jackmaxg/FPGA_FOC_hardware/README.md

# FPGA_FOC_hardware
Hardware for the 6.111 FPGA_FOC project
