jackmaxg/FPGA_FOC_hardware/sim_n_calcs/resolver_amp/amplifier.asc

C1: cap; 10p
L1: ind; 1000µH
Q1: npn; ZTX1048A
Q2: npn; ZTX1048A
Q3: pnp; 2SAR533P
Q4: pnp; 2SAR533P
R1: res; 1k
R2: res; 2.4k
R3: res; 2.2k
R4: res; 3.3
R5: res; 3.3
R6: res; 2.2k
R7: res; 4.7
R8: res; 4.7
R9: res; 1k
R10: res; 416.6
U1: AD8664
V1: voltage; SINE(2.5 2.5 10000 0 0 0 10000)
V2: voltage; 5
V3: voltage; 12
V4: voltage; 6V
Named nets: 0, Vin, 5v, 12v, Vout
.tran 0 0.011 0.01
