jackmaxg/FPGA_FOC_hardware/FPGA_FOC_boards/motherboard.brd

## EAGLE design FPGA_FOC_boards/motherboard.brd (2020-01-12)

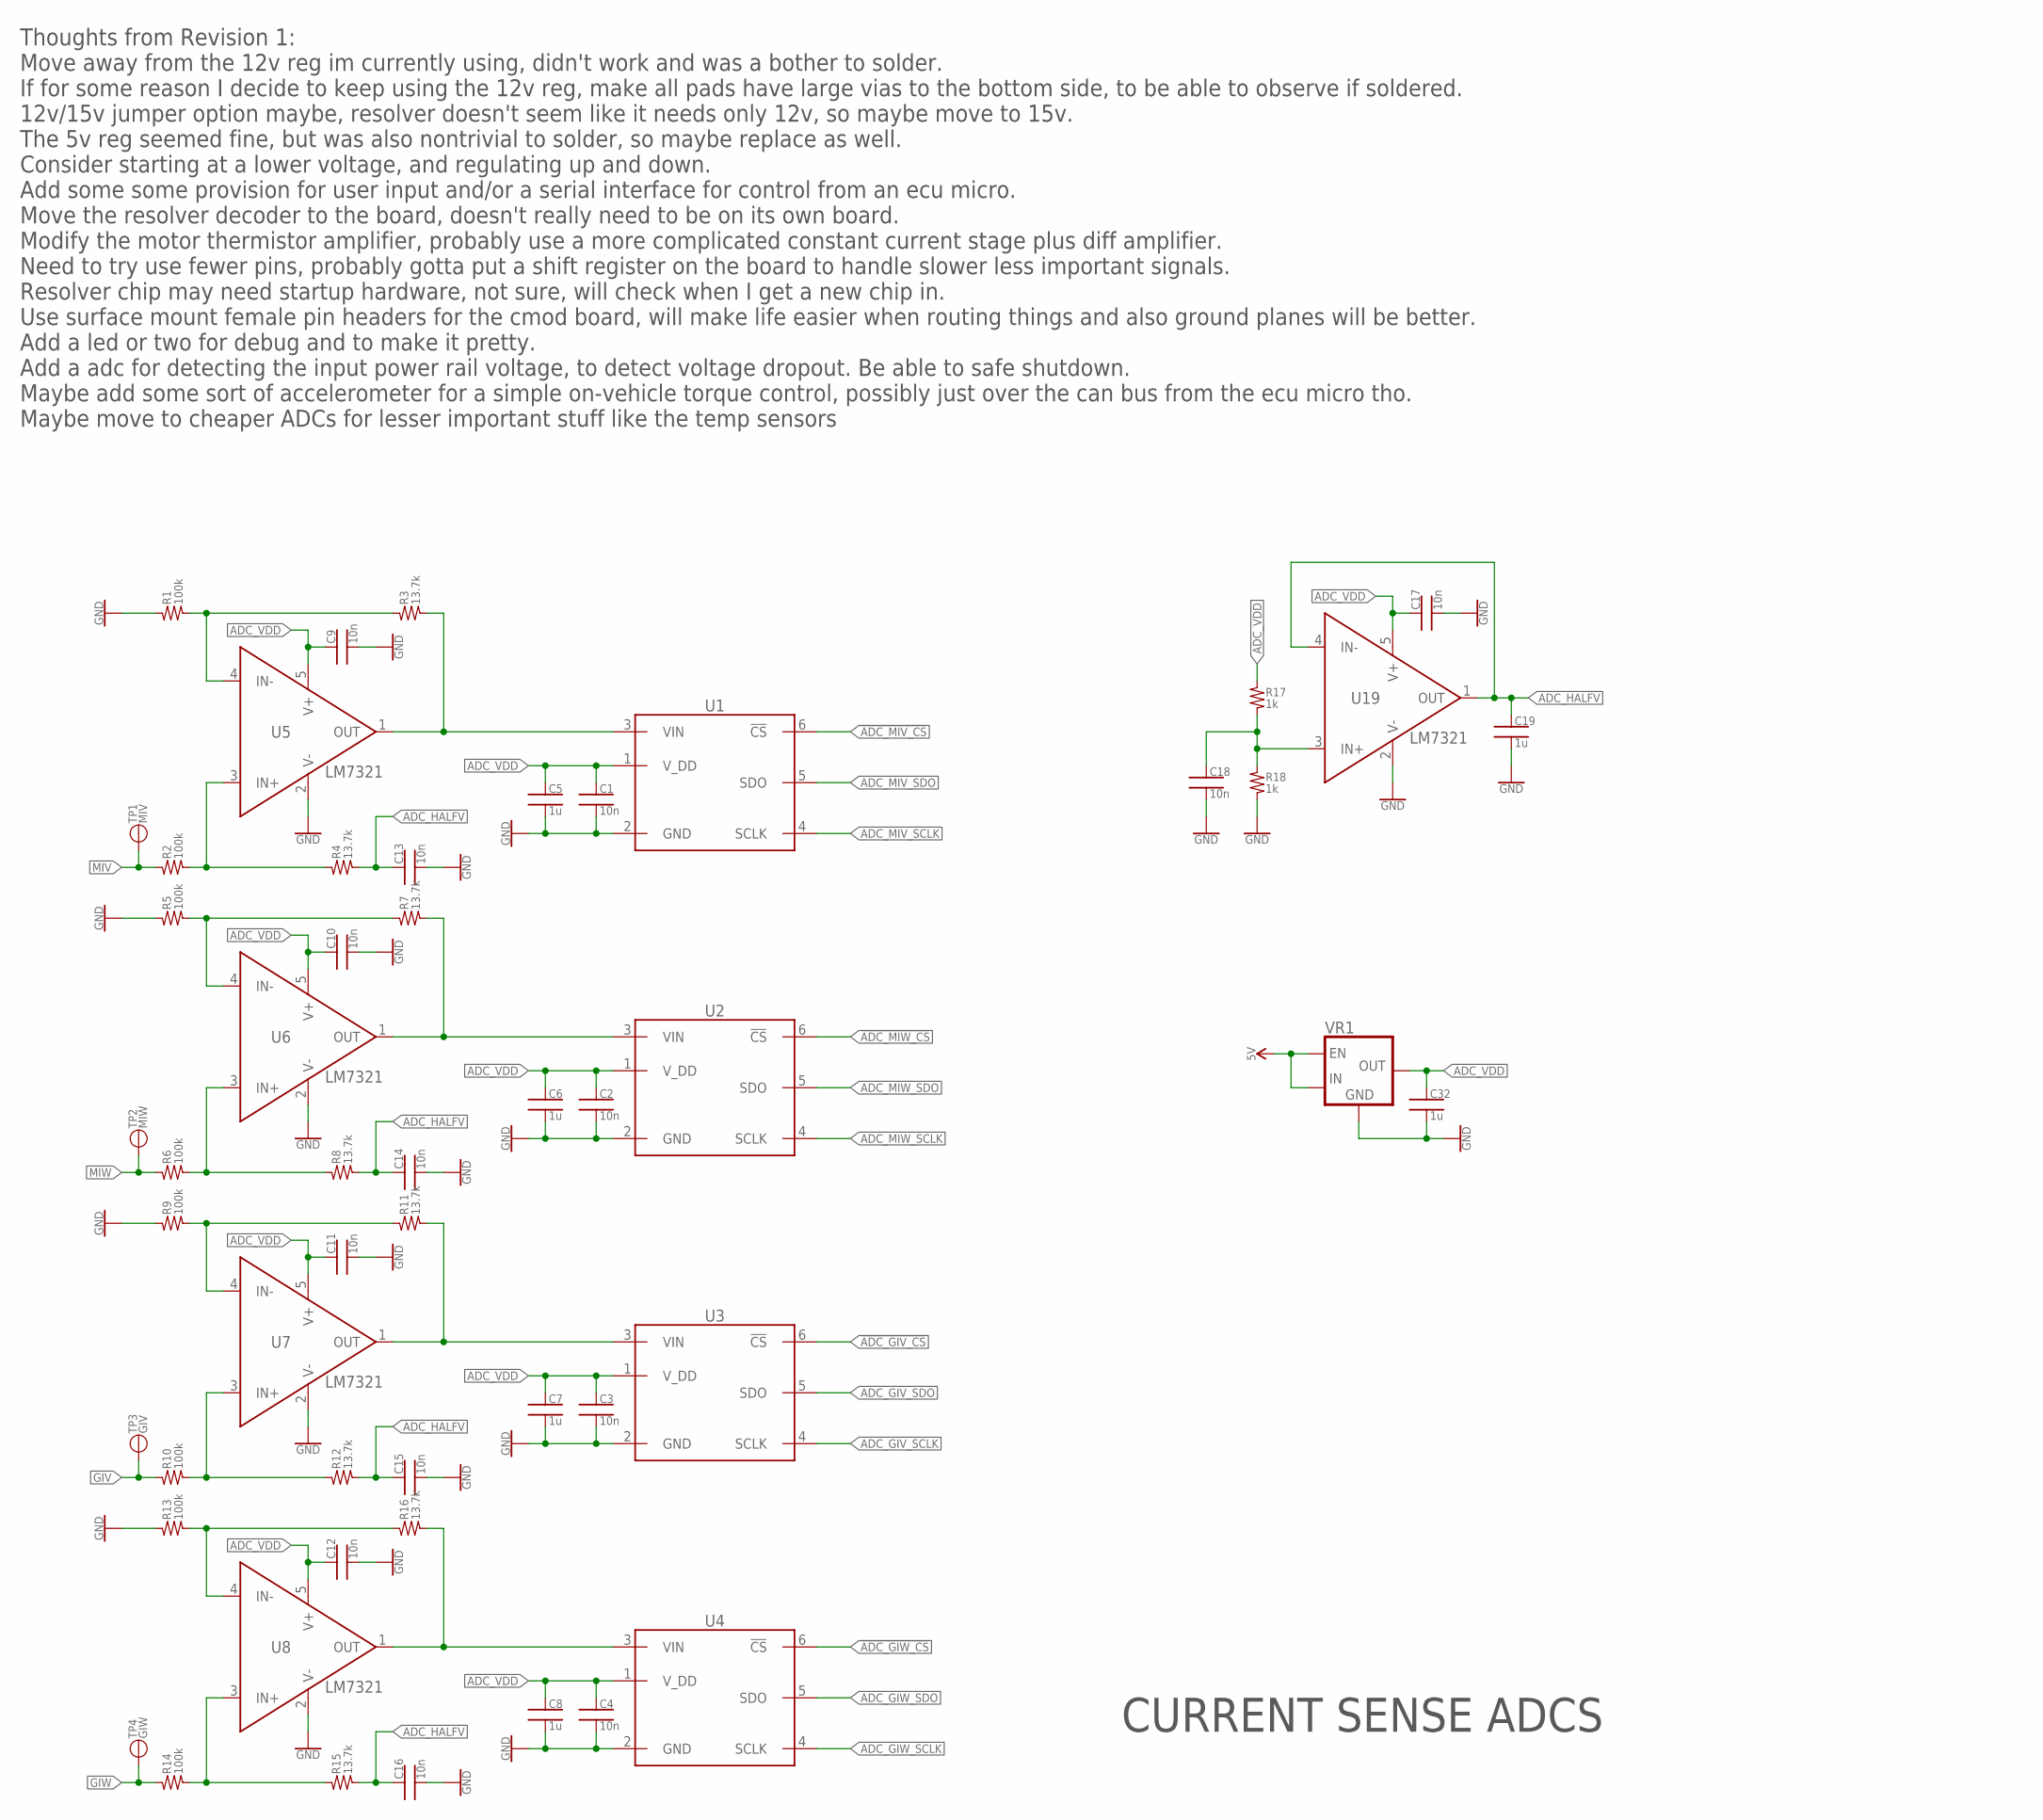
[picture p1: schematic motherboard.sch, sheet 1]

Parts:
C1, C2, C3, C4, C9, C10, C11, C12, C13, C14, C15, C16, C17, C18: 10n; 0402
C5, C6, C7, C8, C19, C32: 1u; 0402
R1, R2, R5, R6, R9, R10, R13, R14: 100k; 0402
R3, R4, R7, R8, R11, R12, R15, R16: 13.7k; 0402
R17, R18: 1k; 0402
TP1: MIV; 1X01_50MIL
TP2: MIW; 1X01_50MIL
TP3: GIV; 1X01_50MIL
TP4: GIW; 1X01_50MIL
U1, U2, U3, U4: ADS7883; SOT23-6
U5, U6, U7, U8, U19: LM7321; SOT23-5
VR1: TLV733P_SOT23; SOT23-5

Connections:
5V: VR1.1 (IN), VR1.3 (EN); also elsewhere on the board
!ADC_GIV_CS: U3.6 (!CS); also elsewhere on the board
!ADC_GIW_CS: U4.6 (!CS); also elsewhere on the board
!ADC_MIV_CS: U1.6 (!CS); also elsewhere on the board
!ADC_MIW_CS: U2.6 (!CS); also elsewhere on the board
ADC_GIV_SCLK: U3.4 (SCLK); also elsewhere on the board
ADC_GIV_SDO: U3.5 (SDO); also elsewhere on the board
ADC_GIW_SCLK: U4.4 (SCLK); also elsewhere on the board
ADC_GIW_SDO: U4.5 (SDO); also elsewhere on the board
ADC_HALFV: C13.1, C14.1, C15.1, C16.1, C19.1, R4.2, R8.2, R12.2, R15.2, U19.1 (OUT), U19.4 (IN-)
ADC_HALFV_REF: C18.1, R17.2, R18.1, U19.3 (IN+)
ADC_MIV_SCLK: U1.4 (SCLK); also elsewhere on the board
ADC_MIV_SDO: U1.5 (SDO); also elsewhere on the board
ADC_MIW_SCLK: U2.4 (SCLK); also elsewhere on the board
ADC_MIW_SDO: U2.5 (SDO); also elsewhere on the board
ADC_VDD: C1.1, C2.1, C3.1, C4.1, C5.1, C6.1, C7.1, C8.1, C9.1, C10.1, C11.1, C12.1, C17.1, C32.1, R17.1, U1.1 (V_DD), U2.1 (V_DD), U3.1 (V_DD), U4.1 (V_DD), U5.5 (V+), U6.5 (V+), U7.5 (V+), U8.5 (V+), U19.5 (V+), VR1.5 (OUT); also elsewhere on the board
GIV: R10.1, TP3.1; also elsewhere on the board
GIW: R14.1, TP4.1; also elsewhere on the board
GND: C1.2, C2.2, C3.2, C4.2, C5.2, C6.2, C7.2, C8.2, C9.2, C10.2, C11.2, C12.2, C13.2, C14.2, C15.2, C16.2, C17.2, C18.2, C19.2, C32.2, R1.1, R5.1, R9.1, R13.1, R18.2, U1.2 (GND), U2.2 (GND), U3.2 (GND), U4.2 (GND), U5.2 (V-), U6.2 (V-), U7.2 (V-), U8.2 (V-), U19.2 (V-), VR1.2 (GND), VR1.4 (GND); also elsewhere on the board
MIV: R2.1, TP1.1; also elsewhere on the board
MIW: R6.1, TP2.1; also elsewhere on the board
U5_IN+: R2.2, R4.1, U5.3 (IN+)
U5_IN-: R1.2, R3.1, U5.4 (IN-)
U5_OUT: R3.2, U1.3 (VIN), U5.1 (OUT)
U6_IN+: R6.2, R8.1, U6.3 (IN+)
U6_IN-: R5.2, R7.1, U6.4 (IN-)
U6_OUT: R7.2, U2.3 (VIN), U6.1 (OUT)
U7_IN+: R10.2, R12.1, U7.3 (IN+)
U7_IN-: R9.2, R11.1, U7.4 (IN-)
U7_OUT: R11.2, U3.3 (VIN), U7.1 (OUT)
U8_IN+: R14.2, R15.1, U8.3 (IN+)
U8_IN-: R13.2, R16.1, U8.4 (IN-)
U8_OUT: R16.2, U4.3 (VIN), U8.1 (OUT)

Notes on the sheet:
CURRENT SENSE ADCS
Thoughts from Revision 1: Move away from the 12v reg im currently using, didn't work and was a bother to solder. If for some reason I decide to keep using the 12v reg, make all pads have large vias to the bottom side, to be able to observe if soldered. 12v/15v jumper option maybe, resolver doesn't 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

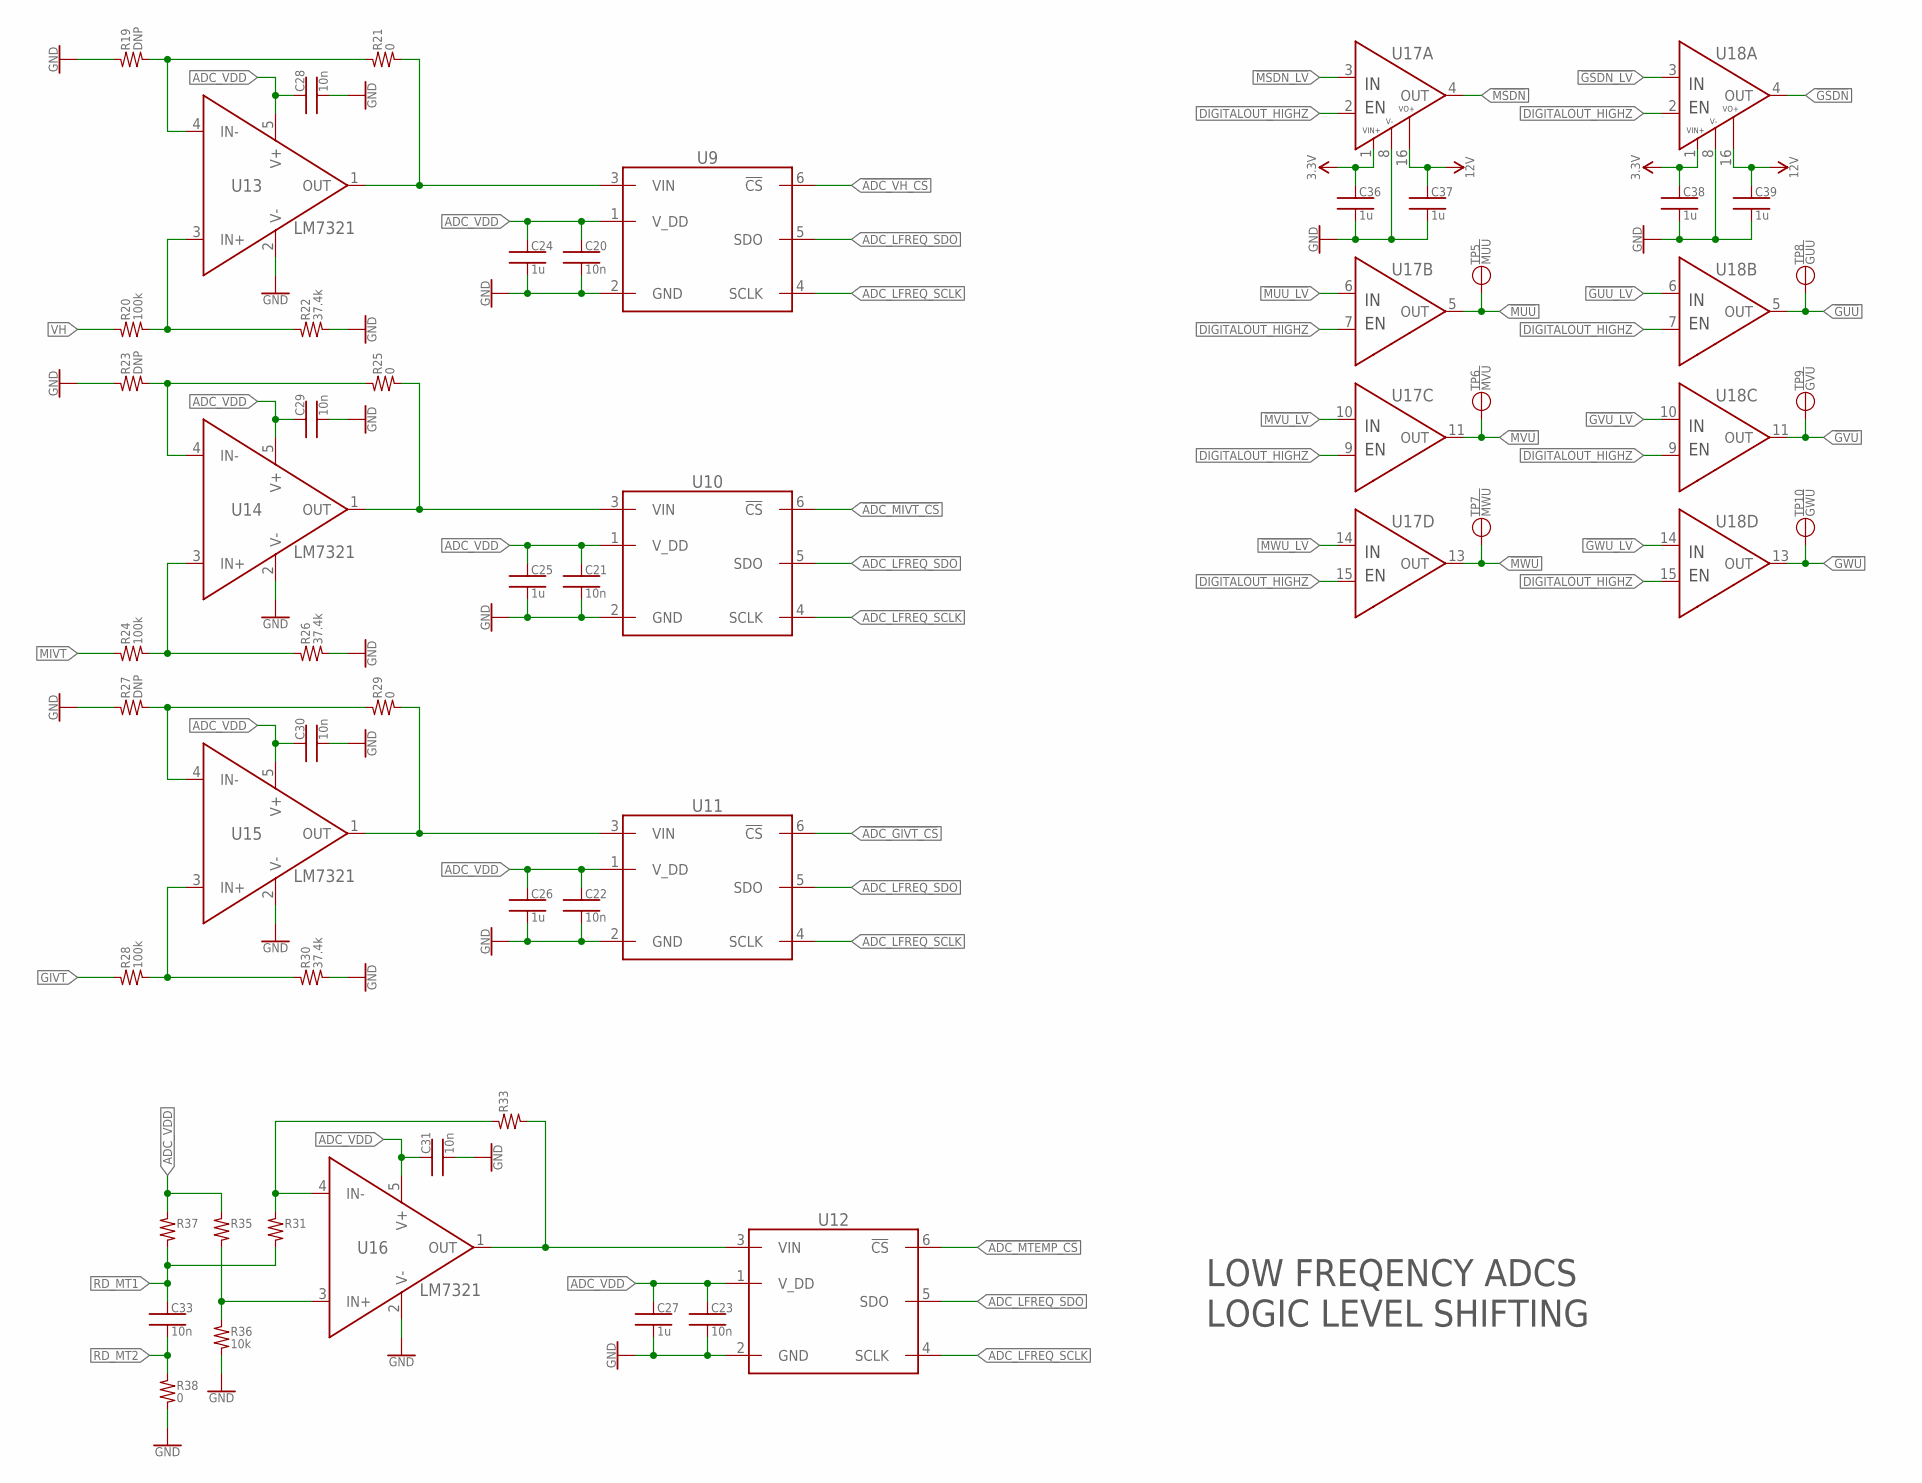
[picture p2: schematic motherboard.sch, sheet 2]

Parts:
C20, C21, C22, C23, C28, C29, C30, C31, C33: 10n; 0402
C24, C25, C26, C27, C36, C37, C38, C39: 1u; 0402
R19, R23, R27: DNP; 0402
R20, R24, R28: 100k; 0402
R21, R25, R29, R38: 0; 0402
R22, R26, R30: 37.4k; 0402
R31, R33, R35, R37: RES_SMD_0402; 0402
R36: 10k; 0402
TP5: !MUU; 1X01_50MIL
TP6: !MVU; 1X01_50MIL
TP7: !MWU; 1X01_50MIL
TP8: !GUU; 1X01_50MIL
TP9: !GVU; 1X01_50MIL
TP10: !GWU; 1X01_50MIL
U9, U10, U11, U12: ADS7883; SOT23-6
U13, U14, U15, U16: LM7321; SOT23-5
U17, U18: CD40109BPWR; TSSOP-16

Connections:
3.3V: C36.1, C38.1, U17.1 (VIN+), U18.1 (VIN+); also elsewhere on the board
12V: C37.1, C39.1, U17.16 (VOUT+), U18.16 (VOUT+); also elsewhere on the board
!ADC_GIVT_CS: U11.6 (!CS); also elsewhere on the board
!ADC_MIVT_CS: U10.6 (!CS); also elsewhere on the board
!ADC_MTEMP_CS: U12.6 (!CS); also elsewhere on the board
!ADC_VH_CS: U9.6 (!CS); also elsewhere on the board
!GSDN: U18.4 (OUT); also elsewhere on the board
!GSDN_LV: U18.3 (IN); also elsewhere on the board
!GUU: TP8.1, U18.5 (OUT); also elsewhere on the board
!GUU_LV: U18.6 (IN); also elsewhere on the board
!GVU: TP9.1, U18.11 (OUT); also elsewhere on the board
!GVU_LV: U18.10 (IN); also elsewhere on the board
!GWU: TP10.1, U18.13 (OUT); also elsewhere on the board
!GWU_LV: U18.14 (IN); also elsewhere on the board
!MSDN: U17.4 (OUT); also elsewhere on the board
!MSDN_LV: U17.3 (IN); also elsewhere on the board
!MUU: TP5.1, U17.5 (OUT); also elsewhere on the board
!MUU_LV: U17.6 (IN); also elsewhere on the board
!MVU: TP6.1, U17.11 (OUT); also elsewhere on the board
!MVU_LV: U17.10 (IN); also elsewhere on the board
!MWU: TP7.1, U17.13 (OUT); also elsewhere on the board
!MWU_LV: U17.14 (IN); also elsewhere on the board
ADC_LFREQ_SCLK: U9.4 (SCLK), U10.4 (SCLK), U11.4 (SCLK), U12.4 (SCLK); also elsewhere on the board
ADC_LFREQ_SDO: U9.5 (SDO), U10.5 (SDO), U11.5 (SDO), U12.5 (SDO); also elsewhere on the board
ADC_VDD: C20.1, C21.1, C22.1, C23.1, C24.1, C25.1, C26.1, C27.1, C28.1, C29.1, C30.1, C31.1, R35.1, R37.1, U9.1 (V_DD), U10.1 (V_DD), U11.1 (V_DD), U12.1 (V_DD), U13.5 (V+), U14.5 (V+), U15.5 (V+), U16.5 (V+); also elsewhere on the board
DIGITALOUT_HIGHZ: U17.2 (EN), U17.7 (EN), U17.9 (EN), U17.15 (EN), U18.2 (EN), U18.7 (EN), U18.9 (EN), U18.15 (EN)
GIVT: R28.1; also elsewhere on the board
GND: C20.2, C21.2, C22.2, C23.2, C24.2, C25.2, C26.2, C27.2, C28.2, C29.2, C30.2, C31.2, C36.2, C37.2, C38.2, C39.2, R19.1, R22.2, R23.1, R26.2, R27.1, R30.2, R36.2, R38.2, U9.2 (GND), U10.2 (GND), U11.2 (GND), U12.2 (GND), U13.2 (V-), U14.2 (V-), U15.2 (V-), U16.2 (V-), U17.8 (V-), U18.8 (V-); also elsewhere on the board
MIVT: R24.1; also elsewhere on the board
RD_MT1: C33.1, R31.2, R37.2
RD_MT2: C33.2, R38.1
U13_IN+: R20.2, R22.1, U13.3 (IN+)
U13_IN-: R19.2, R21.1, U13.4 (IN-)
U13_OUT: R21.2, U9.3 (VIN), U13.1 (OUT)
U14_IN+: R24.2, R26.1, U14.3 (IN+)
U14_IN-: R23.2, R25.1, U14.4 (IN-)
U14_OUT: R25.2, U10.3 (VIN), U14.1 (OUT)
U15_IN+: R28.2, R30.1, U15.3 (IN+)
U15_IN-: R27.2, R29.1, U15.4 (IN-)
U15_OUT: R29.2, U11.3 (VIN), U15.1 (OUT)
U16_IN+: R35.2, R36.1, U16.3 (IN+)
U16_IN-: R31.1, R33.1, U16.4 (IN-)
U16_OUT: R33.2, U12.3 (VIN), U16.1 (OUT)
VH: R20.1; also elsewhere on the board

Notes on the sheet:
LOW FREQENCY ADCS LOGIC LEVEL SHIFTING

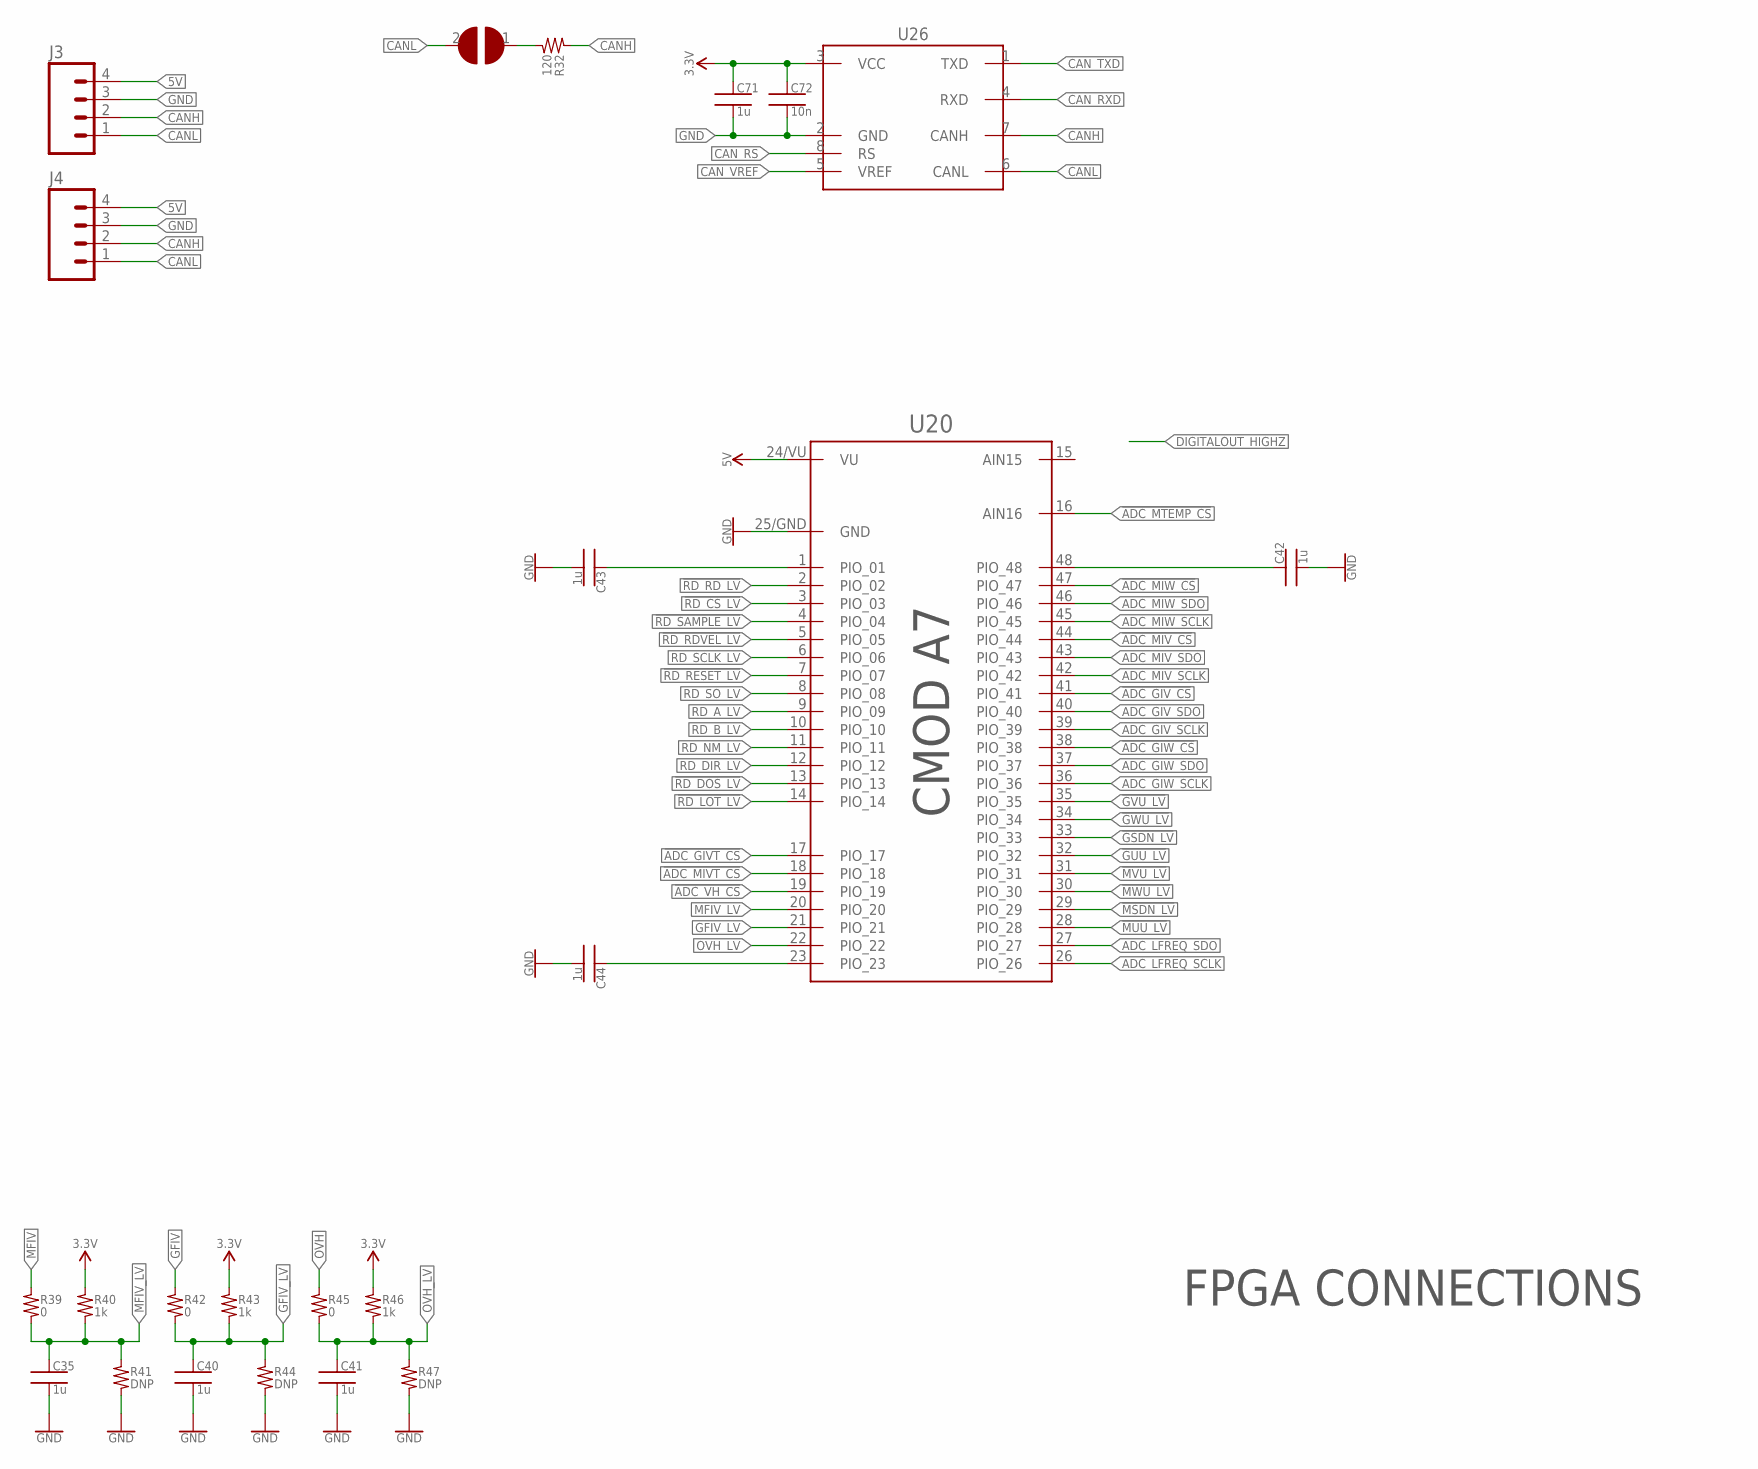
[picture p3: schematic motherboard.sch, sheet 3]

Parts:
C35, C40, C41, C42, C43, C44, C71: 1u; 0402
C72: 10n; 0402
J3, J4: SM04B-SRSS-TB
R32: 120; 0402
R39, R42, R45: 0; 0402
R40, R43, R46: 1k; 0402
R41, R44, R47: DNP; 0402
SJ1: SOLDERABLE_JUMPER_1POS_NP; SJ_2S-NO
U20: CMOD_A7; CMOD_A7_DIP
U26: SN65HVD23X; SOIC_8

Connections:
3.3V: C71.1, C72.1, R40.1, R43.1, R46.1, U26.3 (VCC); also elsewhere on the board
5V: J3.4, J4.4, U20.24/VU (VU); also elsewhere on the board
!ADC_GIVT_CS: U20.17 (PIO_17); also elsewhere on the board
!ADC_GIV_CS: U20.41 (PIO_41); also elsewhere on the board
!ADC_GIW_CS: U20.38 (PIO_38); also elsewhere on the board
!ADC_MIVT_CS: U20.18 (PIO_18); also elsewhere on the board
!ADC_MIV_CS: U20.44 (PIO_44); also elsewhere on the board
!ADC_MIW_CS: U20.47 (PIO_47); also elsewhere on the board
!ADC_MTEMP_CS: U20.16 (AIN16); also elsewhere on the board
!ADC_VH_CS: U20.19 (PIO_19); also elsewhere on the board
!GSDN_LV: U20.33 (PIO_33); also elsewhere on the board
!GUU_LV: U20.32 (PIO_32); also elsewhere on the board
!GVU_LV: U20.35 (PIO_35); also elsewhere on the board
!GWU_LV: U20.34 (PIO_34); also elsewhere on the board
!MSDN_LV: U20.29 (PIO_29); also elsewhere on the board
!MUU_LV: U20.28 (PIO_28); also elsewhere on the board
!MVU_LV: U20.31 (PIO_31); also elsewhere on the board
!MWU_LV: U20.30 (PIO_30); also elsewhere on the board
!RD_CS_LV: U20.3 (PIO_03); also elsewhere on the board
!RD_DOS_LV: U20.13 (PIO_13); also elsewhere on the board
!RD_LOT_LV: U20.14 (PIO_14); also elsewhere on the board
!RD_RDVEL_LV: U20.5 (PIO_05); also elsewhere on the board
!RD_RD_LV: U20.2 (PIO_02); also elsewhere on the board
!RD_RESET_LV: U20.7 (PIO_07); also elsewhere on the board
!RD_SAMPLE_LV: U20.4 (PIO_04); also elsewhere on the board
ADC_GIV_SCLK: U20.39 (PIO_39); also elsewhere on the board
ADC_GIV_SDO: U20.40 (PIO_40); also elsewhere on the board
ADC_GIW_SCLK: U20.36 (PIO_36); also elsewhere on the board
ADC_GIW_SDO: U20.37 (PIO_37); also elsewhere on the board
ADC_LFREQ_SCLK: U20.26 (PIO_26); also elsewhere on the board
ADC_LFREQ_SDO: U20.27 (PIO_27); also elsewhere on the board
ADC_MIV_SCLK: U20.42 (PIO_42); also elsewhere on the board
ADC_MIV_SDO: U20.43 (PIO_43); also elsewhere on the board
ADC_MIW_SCLK: U20.45 (PIO_45); also elsewhere on the board
ADC_MIW_SDO: U20.46 (PIO_46); also elsewhere on the board
CANH: J3.2, J4.2, R32.1, U26.7 (CANH)
CANL: J3.1, J4.1, SJ1.2, U26.6 (CANL)
CAN_RS: U26.8 (RS)
CAN_RXD: U26.4 (RXD)
CAN_TXD: U26.1 (TXD)
CAN_VREF: U26.5 (VREF)
GFIV: R42.1; also elsewhere on the board
GFIV_LV: C40.1, R42.2, R43.2, R44.1, U20.21 (PIO_21)
GND: C35.2, C40.2, C41.2, C42.2, C43.2, C44.2, C71.2, C72.2, J3.3, J4.3, R41.2, R44.2, R47.2, U20.25/GND (GND), U26.2 (GND); also elsewhere on the board
MFIV: R39.1; also elsewhere on the board
MFIV_LV: C35.1, R39.2, R40.2, R41.1, U20.20 (PIO_20)
unnamed: R32.2, SJ1.1
OVH: R45.1; also elsewhere on the board
OVH_LV: C41.1, R45.2, R46.2, R47.1, U20.22 (PIO_22)
PIO_01: C43.1, U20.1 (PIO_01)
PIO_23: C44.1, U20.23 (PIO_23)
PIO_48: C42.1, U20.48 (PIO_48)
RD_A_LV: U20.9 (PIO_09); also elsewhere on the board
RD_B_LV: U20.10 (PIO_10); also elsewhere on the board
RD_DIR_LV: U20.12 (PIO_12); also elsewhere on the board
RD_NM_LV: U20.11 (PIO_11); also elsewhere on the board
RD_SCLK_LV: U20.6 (PIO_06); also elsewhere on the board
RD_SO_LV: U20.8 (PIO_08); also elsewhere on the board

Notes on the sheet:
FPGA CONNECTIONS

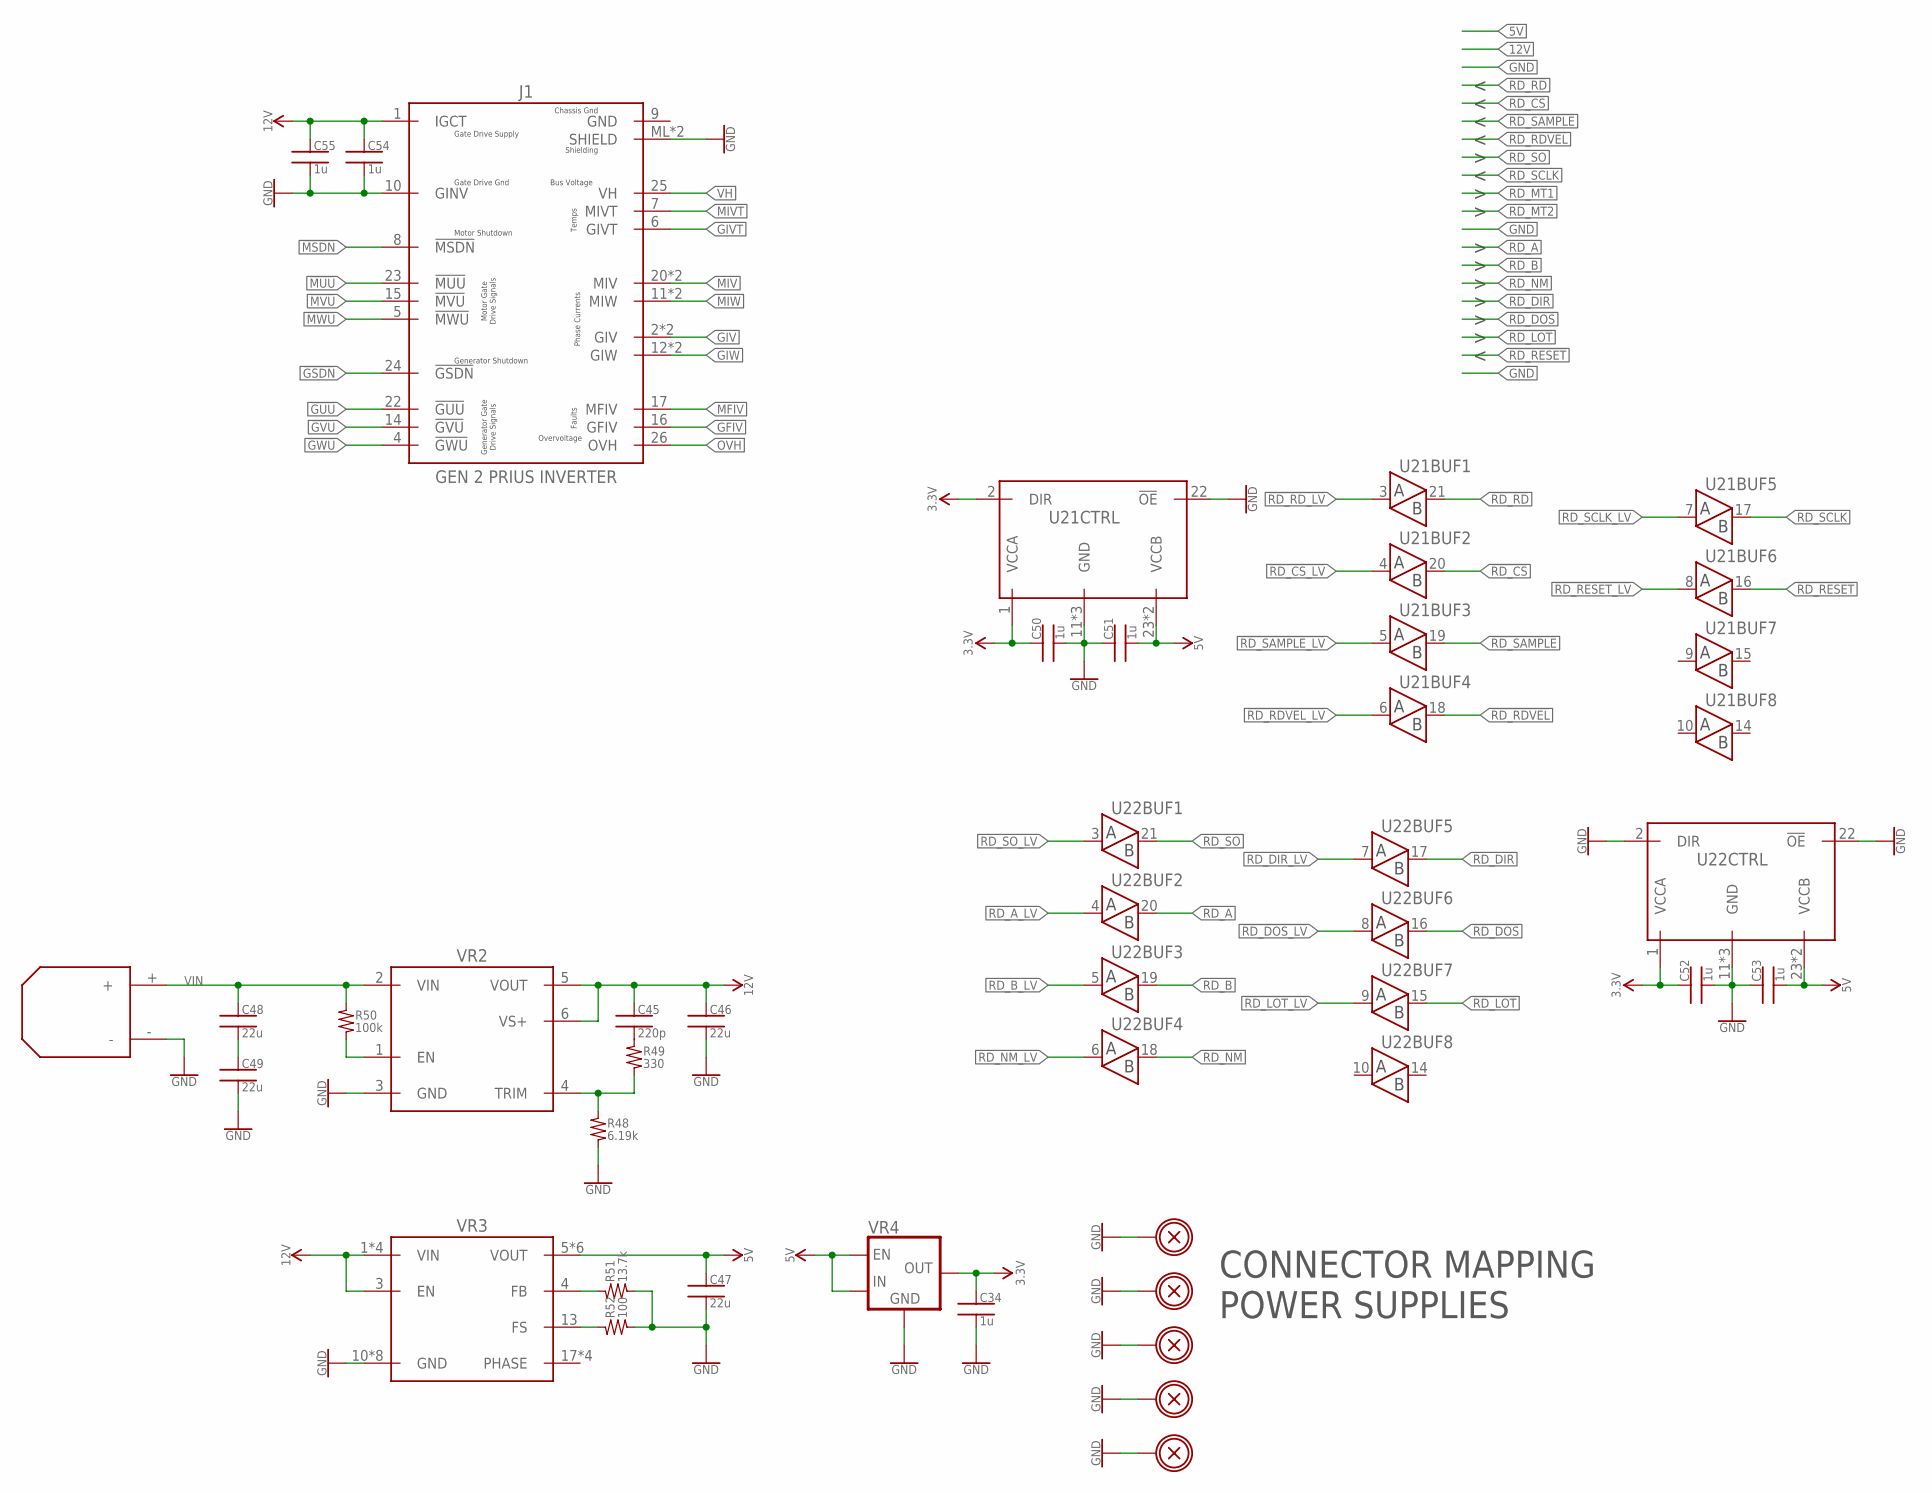
[picture p4: schematic motherboard.sch, sheet 4]

Parts:
C34, C50, C51, C52, C53, C54, C55: 1u; 0402
C45: 220p; 0402
C46, C47, C48, C49: 22u; 1210
H1, H2, H3, H4, H5: BOLTHOLE_M3; M3_HOLE
J1: PRIUS_INV_DB26; L17HTHA
R48: 6.19k; 0402
R49: 330; 0402
R50: 100k; 0402
R51: 13.7k; 0402
R52: 100; 0402
U21, U22: 74LVC8T245; TSSOP-24
U$1: XT30; XT30_HORIZONTAL
VR2: PROLYNX
VR3: MUN24AD03-SM; UPOL_PWR_MODULE
VR4: TLV733P_SOT23; SOT23-5

Connections:
3.3V: C34.1, C50.1, C52.1, U21.1 (VCCA), U21.2 (DIR), U22.1 (VCCA), VR4.5 (OUT); also elsewhere on the board
5V: C47.1, C51.2, C53.2, U21.23 (VCCB), U21.24 (VCCB), U22.23 (VCCB), U22.24 (VCCB), VR3.5 (VOUT), VR3.6 (VOUT), VR3.7 (VOUT), VR3.8 (VOUT), VR3.9 (VOUT), VR3.24 (VOUT), VR4.1 (IN), VR4.3 (EN); also elsewhere on the board
12V: C45.1, C46.1, C54.1, C55.1, J1.1 (IGCT), VR2.5 (VOUT), VR2.6 (VS+), VR3.1 (VIN), VR3.2 (VIN), VR3.3 (EN), VR3.20 (VIN), VR3.21 (VIN); also elsewhere on the board
!GSDN: J1.24 (!GSDN); also elsewhere on the board
!GUU: J1.22 (!GUU); also elsewhere on the board
!GVU: J1.14 (!GVU); also elsewhere on the board
!GWU: J1.4 (!GWU); also elsewhere on the board
!MSDN: J1.8 (!MSDN); also elsewhere on the board
!MUU: J1.23 (!MUU); also elsewhere on the board
!MVU: J1.15 (!MVU); also elsewhere on the board
!MWU: J1.5 (!MWU); also elsewhere on the board
!RD_CS: U21.20 (B); also elsewhere on the board
!RD_CS_LV: U21.4 (A); also elsewhere on the board
!RD_DOS: U22.16 (B); also elsewhere on the board
!RD_DOS_LV: U22.8 (A); also elsewhere on the board
!RD_LOT: U22.15 (B); also elsewhere on the board
!RD_LOT_LV: U22.9 (A); also elsewhere on the board
!RD_RD: U21.21 (B); also elsewhere on the board
!RD_RDVEL: U21.18 (B); also elsewhere on the board
!RD_RDVEL_LV: U21.6 (A); also elsewhere on the board
!RD_RD_LV: U21.3 (A); also elsewhere on the board
!RD_RESET: U21.16 (B); also elsewhere on the board
!RD_RESET_LV: U21.8 (A); also elsewhere on the board
!RD_SAMPLE: U21.19 (B); also elsewhere on the board
!RD_SAMPLE_LV: U21.5 (A); also elsewhere on the board
GFIV: J1.16 (GFIV); also elsewhere on the board
GIV: J1.2 (GIV), J1.3 (GIV); also elsewhere on the board
GIVT: J1.6 (GIVT); also elsewhere on the board
GIW: J1.12 (GIW), J1.13 (GIW); also elsewhere on the board
GND: C34.2, C46.2, C47.2, C49.2, C50.2, C51.1, C52.2, C53.1, C54.2, C55.2, H1.P, H2.P, H3.P, H4.P, H5.P, J1.10 (GINV), J1.ML (SHIELD), J1.MR (SHIELD), R48.2, R51.2, R52.2, U21.11 (GND), U21.12 (GND), U21.13 (GND), U21.22 (!OE), U22.2 (DIR), U22.11 (GND), U22.12 (GND), U22.13 (GND), U22.22 (!OE), U$1.-, VR2.3 (GND), VR3.10 (GND), VR3.11 (GND), VR3.12 (GND), VR3.14 (GND), VR3.15 (GND), VR3.16 (GND), VR3.23 (GND), VR3.25 (GND), VR4.2 (GND), VR4.4 (GND); also elsewhere on the board
MFIV: J1.17 (MFIV); also elsewhere on the board
MIV: J1.20 (MIV), J1.21 (MIV); also elsewhere on the board
MIVT: J1.7 (MIVT); also elsewhere on the board
MIW: J1.11 (MIW), J1.19 (MIW); also elsewhere on the board
unnamed: C45.2, R49.1
OVH: J1.26 (OVH); also elsewhere on the board
RD_A: U22.20 (B); also elsewhere on the board
RD_A_LV: U22.4 (A); also elsewhere on the board
RD_B: U22.19 (B); also elsewhere on the board
RD_B_LV: U22.5 (A); also elsewhere on the board
RD_DIR: U22.17 (B); also elsewhere on the board
RD_DIR_LV: U22.7 (A); also elsewhere on the board
RD_NM: U22.18 (B); also elsewhere on the board
RD_NM_LV: U22.6 (A); also elsewhere on the board
RD_SCLK: U21.17 (B); also elsewhere on the board
RD_SCLK_LV: U21.7 (A); also elsewhere on the board
RD_SO: U22.21 (B); also elsewhere on the board
RD_SO_LV: U22.3 (A); also elsewhere on the board
VH: J1.25 (VH); also elsewhere on the board
VIN: C48.1, R50.1, U$1.+, VR2.2 (VIN)
VIN_BYP_MID: C48.2, C49.1
VR2_EN: R50.2, VR2.1 (EN)
VR2_TRIM: R48.1, R49.2, VR2.4 (TRIM)
VR3_FB: R51.1, VR3.4 (FB)
VR3_FS: R52.1, VR3.13 (FS)

Notes on the sheet:
CONNECTOR MAPPING POWER SUPPLIES
