jackmaxg/FPGA_FOC_hardware/FPGA_FOC_boards/motherboard.brd

## EAGLE design FPGA_FOC_boards/motherboard.brd (continued)

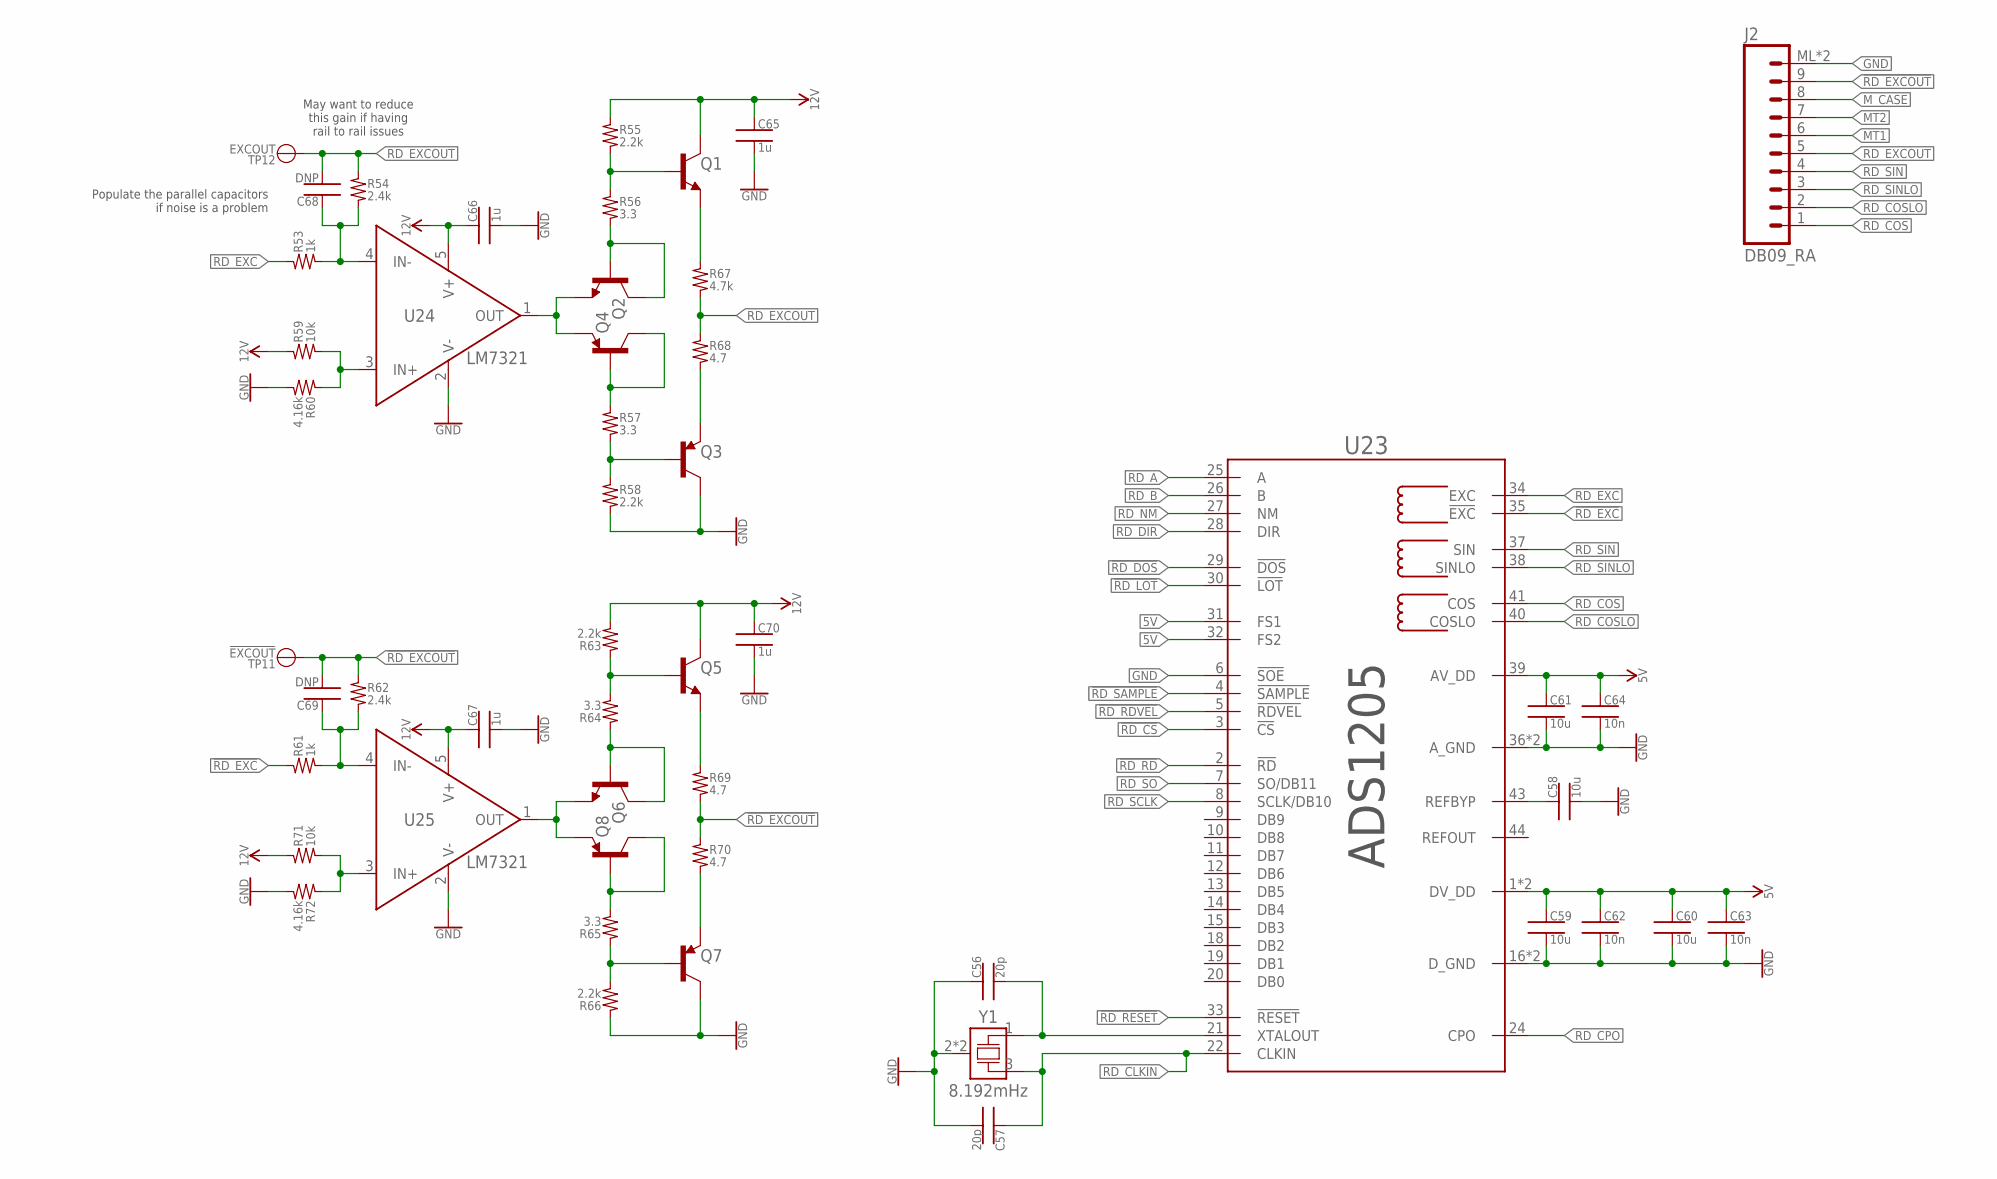
[picture p5: schematic motherboard.sch, sheet 5]

Parts:
C56, C57: 20p; 0402
C58, C59, C60, C61: 10u; 0603
C62, C63, C64: 10n; 0402
C65, C66, C67, C70: 1u; 0402
C68, C69: DNP; 0402
J2: DB09_RA; AE10921
Q1, Q2, Q5, Q6: BJT_NPN; SOT23-3
Q3, Q4, Q7, Q8: BJT_PNP; SOT23-3
R53, R61: 1k; 0402
R54, R62: 2.4k; 0402
R55, R58, R63, R66: 2.2k; 0402
R56, R57, R64, R65: 3.3; 0402
R59, R71: 10k; 0402
R60, R72: 4.16k; 0402
R67: 4.7k; 0805
R68, R69, R70: 4.7; 0805
TP11: !EXCOUT; 1X01_50MIL
TP12: EXCOUT; 1X01_50MIL
U23: ADS1205; LQFP44
U24, U25: LM7321; SOT23-5
Y1: 8.192mHz; 5X3.2MM_SMD_XTAL

Connections:
5V: C59.1, C60.1, C61.1, C62.1, C63.1, C64.1, U23.1 (DV_DD), U23.17 (DV_DD), U23.31 (FS1), U23.32 (FS2), U23.39 (AV_DD); also elsewhere on the board
12V: C65.1, C66.1, C67.1, C70.1, Q1.3 (C), Q5.3 (C), R55.1, R59.1, R63.2, R71.1, U24.5 (V+), U25.5 (V+); also elsewhere on the board
!RD_CS: U23.3 (!CS); also elsewhere on the board
!RD_DOS: U23.29 (!DOS); also elsewhere on the board
!RD_EXC: R61.1, U23.35 (!EXC)
!RD_EXCOUT: C69.2, J2.9, R62.1, R69.2, R70.1, TP11.1
!RD_LOT: U23.30 (!LOT); also elsewhere on the board
!RD_RD: U23.2 (!RD); also elsewhere on the board
!RD_RDVEL: U23.5 (!RDVEL); also elsewhere on the board
!RD_RESET: U23.33 (!RESET); also elsewhere on the board
!RD_SAMPLE: U23.4 (!SAMPLE); also elsewhere on the board
GND: C56.1, C57.2, C58.2, C59.2, C60.2, C61.2, C62.2, C63.2, C64.2, C65.2, C66.2, C67.2, C70.2, J2.ML (10), J2.MR (10), Q3.3 (C), Q7.3 (C), R58.2, R60.2, R66.1, R72.2, U23.6 (!SOE), U23.16 (D_GND), U23.23 (D_GND), U23.36 (A_GND), U23.42 (A_GND), U24.2 (V-), U25.2 (V-), Y1.2 (CASE), Y1.4 (CASE); also elsewhere on the board
MT1: J2.6
MT2: J2.7
M_CASE: J2.8
Q1_BASE: Q1.1 (B), R55.2, R56.1
Q1_EMITTER: Q1.2 (E), R67.1
Q2_BC: Q2.1 (B), Q2.3 (C), R56.2
Q3_BASE: Q3.1 (B), R57.2, R58.1
Q3_EMITTER: Q3.2 (E), R68.2
Q4_BC: Q4.1 (B), Q4.3 (C), R57.1
Q5_BASE: Q5.1 (B), R63.1, R64.2
Q5_EMITTER: Q5.2 (E), R69.1
Q6_BC: Q6.1 (B), Q6.3 (C), R64.1
Q7_BASE: Q7.1 (B), R65.1, R66.2
Q7_EMITTER: Q7.2 (E), R70.2
Q8_BC: Q8.1 (B), Q8.3 (C), R65.2
RD_A: U23.25 (A); also elsewhere on the board
RD_B: U23.26 (B); also elsewhere on the board
RD_CLKIN: C57.1, U23.22 (CLKIN), Y1.3 (X2)
RD_COS: J2.1, U23.41 (COS)
RD_COSLO: J2.2, U23.40 (COSLO)
RD_CPO: U23.24 (CPO)
RD_DIR: U23.28 (DIR); also elsewhere on the board
RD_EXC: R53.1, U23.34 (EXC)
RD_EXCOUT: C68.2, J2.5, R54.1, R67.2, R68.1, TP12.1
RD_NM: U23.27 (NM); also elsewhere on the board
RD_REFBYP: C58.1, U23.43 (REFBYP)
RD_SCLK: U23.8 (SCLK/DB10); also elsewhere on the board
RD_SIN: J2.4, U23.37 (SIN)
RD_SINLO: J2.3, U23.38 (SINLO)
RD_SO: U23.7 (SO/DB11); also elsewhere on the board
RD_XTALOUT: C56.2, U23.21 (XTALOUT), Y1.1 (X1)
U24_IN+: R59.2, R60.1, U24.3 (IN+)
U24_IN-: C68.1, R53.2, R54.2, U24.4 (IN-)
U24_OUT: Q2.2 (E), Q4.2 (E), U24.1 (OUT)
U25_IN+: R71.2, R72.1, U25.3 (IN+)
U25_IN-: C69.1, R61.2, R62.2, U25.4 (IN-)
U25_OUT: Q6.2 (E), Q8.2 (E), U25.1 (OUT)

Notes on the sheet:
Populate the parallel capacitors if noise is a problem
May want to reduce this gain if having rail to rail issues

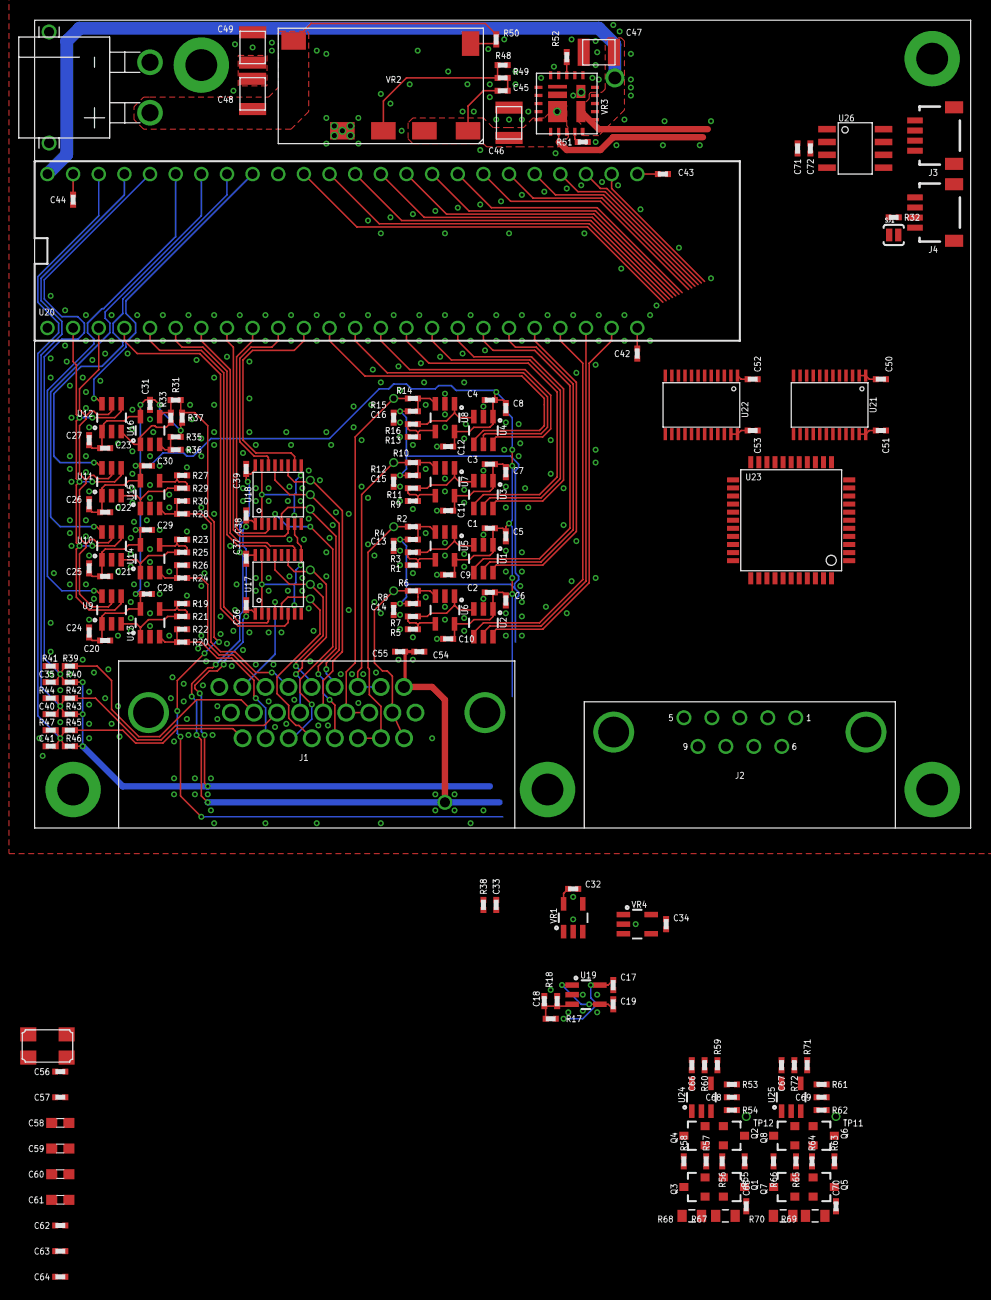
[picture p6: board motherboard.brd from above]

Board: 2 copper layers, 92.7 x 80.0 mm, 205 parts (0 on the bottom side), 149 nets.
