jackmaxg/FPGA_FOC_hardware/FPGA_FOC_boards/ResolverBoard.brd

## EAGLE design FPGA_FOC_boards/ResolverBoard.brd (2019-11-25)

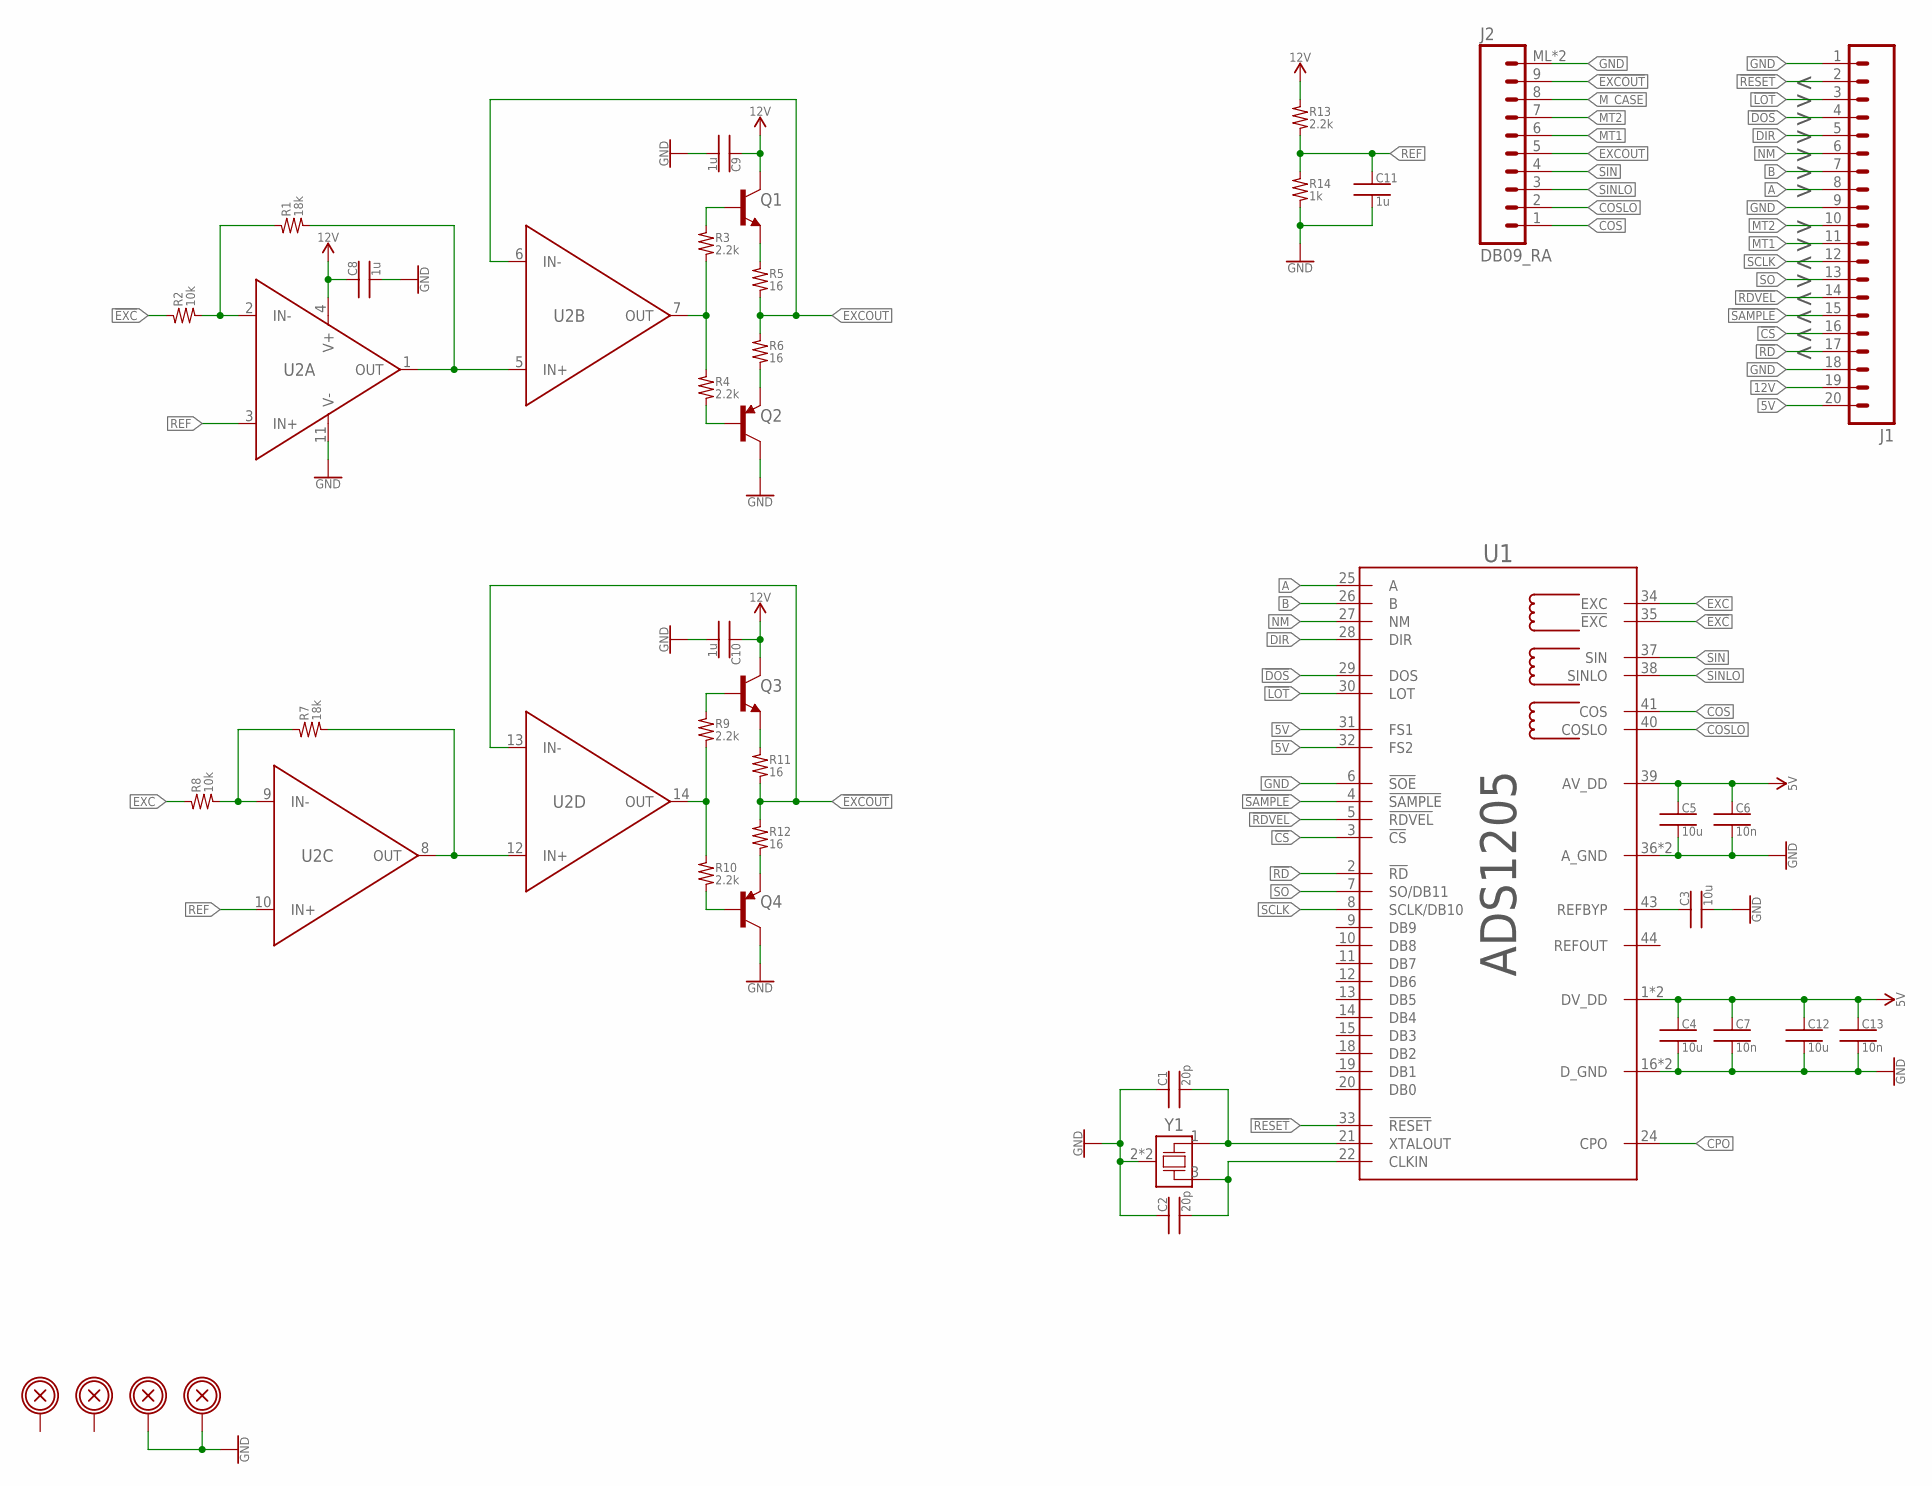
[picture p7: schematic ResolverBoard.sch]

Parts:
C1, C2: 20p; 0402
C3, C4, C5, C12: 10u; 0603
C6, C7, C13: 10n; 0402
C8, C9, C10, C11: 1u; 0402
H1, H2, H3, H4: BOLTHOLE_M3; M3_HOLE
J1: M20; 1X20
J2: DB09_RA; AE10921
Q1, Q3: BJT_NPN; SOT23-3
Q2, Q4: BJT_PNP; SOT23-3
R1, R7: 18k; 0402
R2, R8: 10k; 0402
R3, R4, R9, R10, R13: 2.2k; 0402
R5, R6, R11, R12: 16; 0805
R14: 1k; 0402
U1: ADS1205; LQFP44
U2: OPA4171D; SOIC_14
Y1: LFXTAL061486; 5X3.2MM_SMD_XTAL

Connections:
5V: C4.1, C5.1, C6.1, C7.1, C12.1, C13.1, J1.20, U1.1 (DV_DD), U1.17 (DV_DD), U1.31 (FS1), U1.32 (FS2), U1.39 (AV_DD)
12V: C8.1, C9.1, C10.1, J1.19, Q1.3 (C), Q3.3 (C), R13.1, U2.4 (V+)
!CS: J1.16, U1.3 (!CS)
!DOS: J1.4, U1.29 (DOS)
!EXC: R2.1, U1.35 (!EXC)
!EXCOUT: J2.9, R11.2, R12.1, U2.13 (IN-)
!LOT: J1.3, U1.30 (LOT)
!RD: J1.17, U1.2 (!RD)
!RDVEL: J1.14, U1.5 (!RDVEL)
!RESET: J1.2, U1.33 (!RESET)
!SAMPLE: J1.15, U1.4 (!SAMPLE)
A: J1.8, U1.25 (A)
B: J1.7, U1.26 (B)
CLKIN: C2.2, U1.22 (CLKIN), Y1.3 (X2)
COS: J2.1, U1.41 (COS)
COSLO: J2.2, U1.40 (COSLO)
CPO: U1.24 (CPO)
DIR: J1.5, U1.28 (DIR)
EXC: R8.1, U1.34 (EXC)
EXCOUT: J2.5, R5.2, R6.1, U2.6 (IN-)
GND: C1.1, C2.1, C3.2, C4.2, C5.2, C6.2, C7.2, C8.2, C9.2, C10.2, C11.2, C12.2, C13.2, H3.P, H4.P, J1.1, J1.9, J1.18, J2.ML (10), J2.MR (10), Q2.3 (C), Q4.3 (C), R14.2, U1.6 (!SOE), U1.16 (D_GND), U1.23 (D_GND), U1.36 (A_GND), U1.42 (A_GND), U2.11 (V-), Y1.2 (CASE), Y1.4 (CASE)
MT1: J1.11, J2.6
MT2: J1.10, J2.7
M_CASE: J2.8
NM: J1.6, U1.27 (NM)
Q1BASE: Q1.1 (B), R3.1
Q1EMITTER: Q1.2 (E), R5.1
Q2BASE: Q2.1 (B), R4.2
Q2EMITTER: Q2.2 (E), R6.2
Q3BASE: Q3.1 (B), R9.1
Q3EMITTER: Q3.2 (E), R11.1
Q4BASE: Q4.1 (B), R10.2
Q4EMITTER: Q4.2 (E), R12.2
REF: C11.1, R13.2, R14.1, U2.3 (IN+), U2.10 (IN+)
REFBYP: C3.1, U1.43 (REFBYP)
SCLK: J1.12, U1.8 (SCLK/DB10)
SIN: J2.4, U1.37 (SIN)
SINLO: J2.3, U1.38 (SINLO)
SO: J1.13, U1.7 (SO/DB11)
U2A_IN-: R1.1, R2.2, U2.2 (IN-)
U2A_OUT: R1.2, U2.1 (OUT), U2.5 (IN+)
U2B_OUT: R3.2, R4.1, U2.7 (OUT)
U2C_IN-: R7.1, R8.2, U2.9 (IN-)
U2C_OUT: R7.2, U2.8 (OUT), U2.12 (IN+)
U2D_OUT: R9.2, R10.1, U2.14 (OUT)
XTALOUT: C1.2, U1.21 (XTALOUT), Y1.1 (X1)

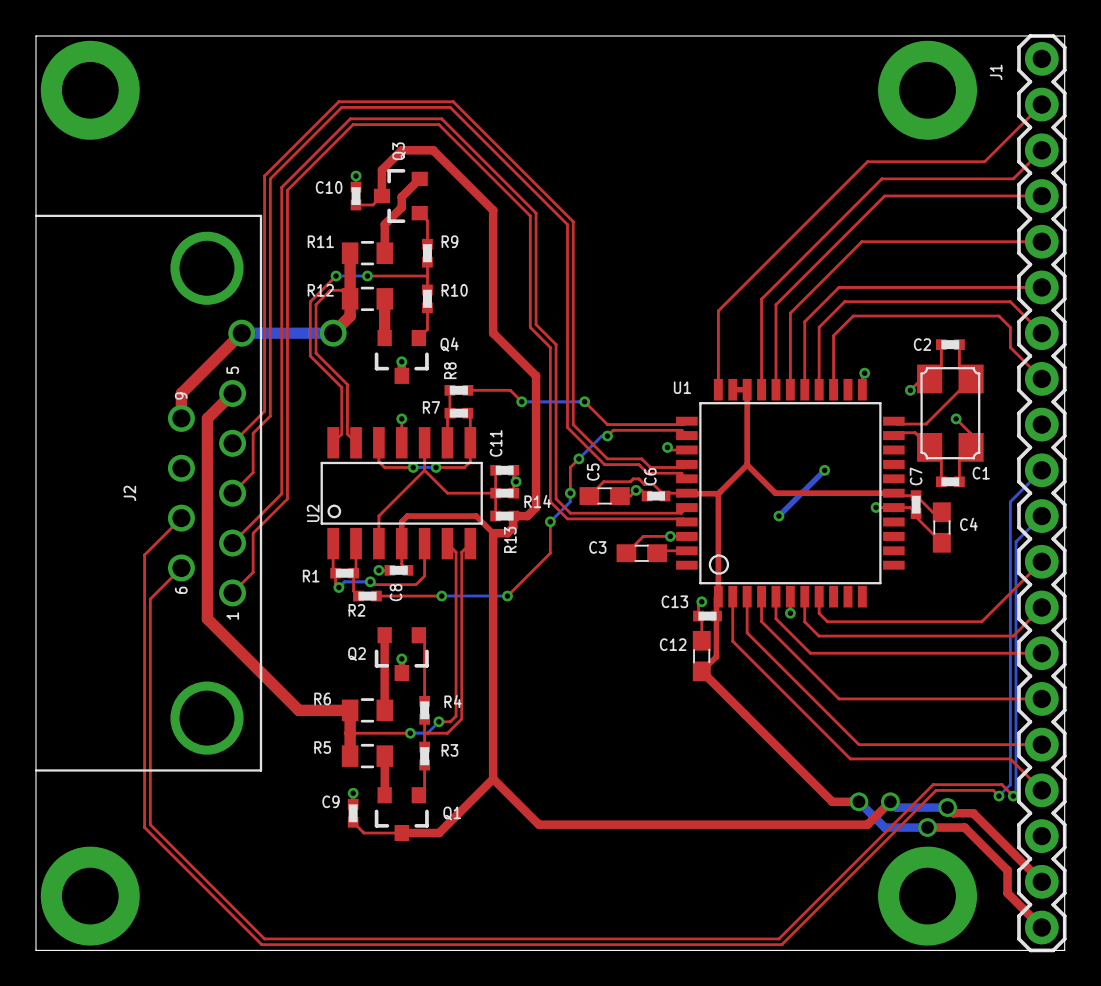
[picture p8: board ResolverBoard.brd from above]

Board: 2 copper layers, 57.1 x 50.8 mm, 40 parts (0 on the bottom side), 44 nets.
