jackmaxg/FPGA_FOC_hardware/(commit log)

2019-11-03 tweaked gitattributes, and started a simple eagleproject
    [cmod_A7-35T_carrier.sch]
2019-11-25 first revision of both motherboard and resolverboard finished
    [ResolverBoard.brd, ResolverBoard.sch, cmod_A7-35T_carrier.sch, motherboard.brd, motherboard.sch]
2020-01-09 added the V1 BOM, consider this the last V1 commit
    [FPGA_FOC_BOM_v1.csv]
2020-01-10 started adding in the resolver hardware onto the motherboard, began ripping up some parts of the v1 board to make room for resolver hardware
    [ResolverBoard.sch, motherboard.brd, motherboard.sch]
2020-01-12 did some calculations for part values for the resolver buffer stage
2020-01-12 started the CCU board
    [CCU_board.brd, CCU_board.sch, motherboard.brd, motherboard.sch]
